donnersm/CRTIMER/hardware/BOM_PCB_CR Timer_2022-02-24.csv

ID | Name | Designator | Footprint | Quantity | Manufacturer Part | Manufacturer | Supplier | Supplier Part | Price
1 | MM1Z5V1 | D1 | SOD-123_L2.7-W1.6-LS3.7-RD | 1 | MM1Z5V1 | SEMTECH | LCSC | C81601 | 0.018
2 | 1K | R9,R3,R2,R6 | R0805 | 4 | 0805W8F1001T5E | UniOhm | LCSC | C17513 | 0.002
3 | Arduino_Nano_Header | J1 | DIP-30_L43.18-W15.24-ARDUINONANO | 1
4 | HL-PC-2012H322W-L | LED1 | LED0805-RD | 1 | HL-PC-2012H322W-L(6000K-7000K) | HONGLITRONIC(Hongli Zhihui (HONGLITRONIC)) | LCSC | C497944 | 0.017
5 | FDN340P | Q1 | SOT-23-3_L2.9-W1.3-P1.90-LS2.4-BR | 1 | FDN340P | TECH PUBLIC(台舟) | LCSC | C2890122 | 0.057
6 | 74HC4050D,653 | U2 | SOP-16_L10.0-W3.9-P1.27-LS6.0-BL | 1 | 74HC4050D,653 | Nexperia | LCSC | C43181 | 0.33
7 | 10uF | C1,C2 | C1206 | 2 | CL31A106KBHNNNE | SAMSUNG | LCSC | C13585 | 0.041
8 | 100nF | C3,C4,C5,C7 | C0805 | 4 | CC0805KRX7R9BB104 | YAGEO | LCSC | C49678 | 0.005
9 | DS1139-06-08SS4BSR | CARD1 | TF-SMD_DS1139-06-08SS4BSR | 1 | DS1139-06-08SS4BSR | CONNFLY | LCSC | C86574 | 0.268
10 | 22041021 | CN2,CN3,CN4 | CONN-TH_22041021 | 3 | 22041021 | MOLEX | LCSC | C185215 | 0.09
11 | 22041031 | P1 | CONN-TH_3P-P2.54_22041031 | 1 | 22041031 | MOLEX | LCSC | C293437 | 0.089
12 | FDN335N | Q2,Q3 | SOT-23-3_L2.9-W1.3-P1.90-LS2.4-BR | 2 | FDN335N | HUASHUO | LCSC | C845588 | 0.038
13 | 10K | R1,R4,R5 | R0805 | 3 | 0805W8F1002T5E | UniOhm | LCSC | C17414 | 0.002
14 | 470 | R7 | R0805 | 1 | 0805W8F4700T5E | UniOhm | LCSC | C17710 | 0.003
15 | TS-1071AS-A1B3-D4 | SW1 | SW-SMD_L4.0-W3.0-LS4.8 | 1 | TS-1071AS-A1B3-D4 | Yuandi | LCSC | C492861 | 0.113
16 | AMS1117-5.0_C347223 | U1 | SOT-223_L6.7-W3.5-P2.30-BR | 1 | AMS1117-5.0 | Youtai Semiconductor Co., Ltd. | LCSC | C347223 | 0.081
17 | LP2985-50DBVR | U3 | SOT-23-5_L3.0-W1.7-P0.95-LS2.8-BR | 1 | LP2985-50DBVR | Texas Instruments | LCSC | C74511 | 0.403
18 | PINHEADER1X7 | U4 | PINHEADER1X8N | 0 |  |  |  | undefined
19 | PINHEADER1X8 | U5 | PINHEADER1X8 | 0 |  |  |  | undefined
20 | BC547CTA | Q4 | TO-92-3_L4.8-W3.7-P2.54-L | 1 | BC547CTA | onsemi(安森美) | LCSC | C900799 | 0.085
21 | 4.7K | R8 | R0805 | 1 | 0805W8F4701T5E | UniOhm | LCSC | C17673 | 0.003
