donnersm/CRTIMER/hardware/Schematic_CR Timer_2022-01-15.pdf

# 4Y 10 5A 11 5Y 12 N.C 13 6A 14 6Y 15 N.C 16

## SD CARD

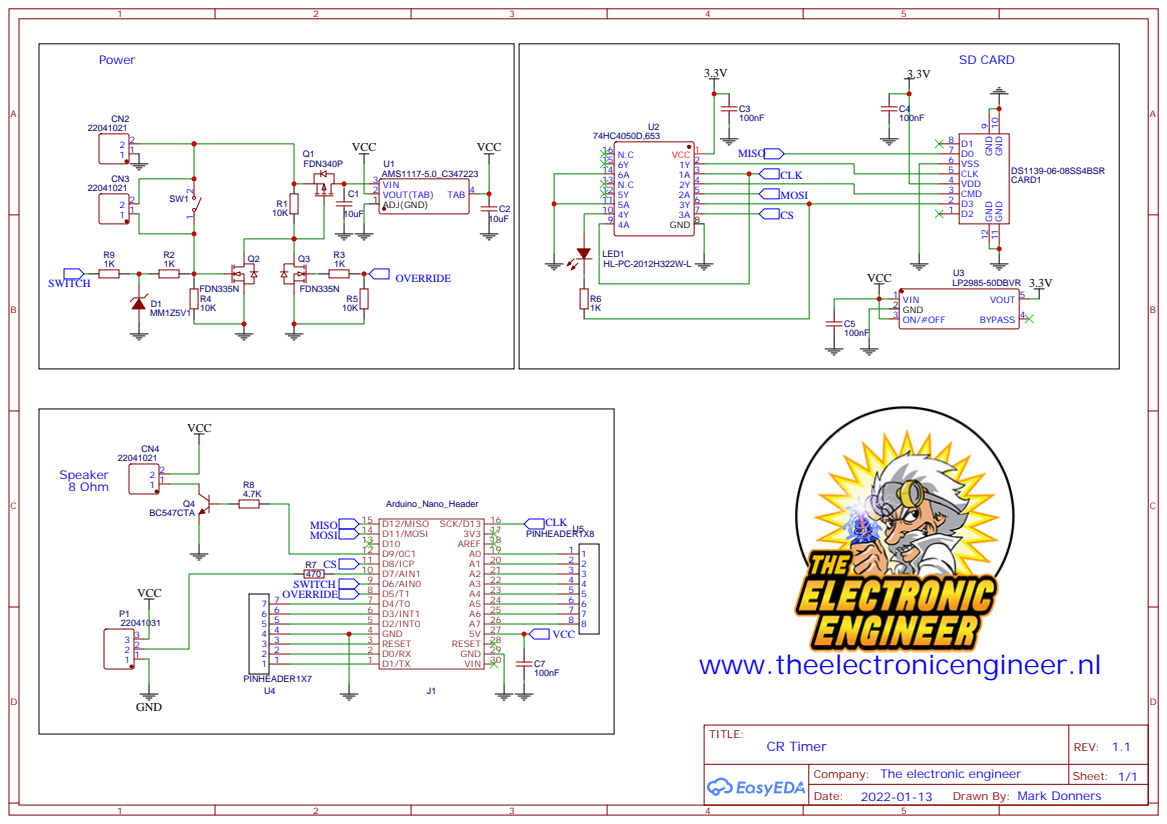
[picture p1: page 1]

Company: The electronic engineer

Drawn By: Mark Donners
