donnersm/CRTIMER/hardware/assembly.pdf

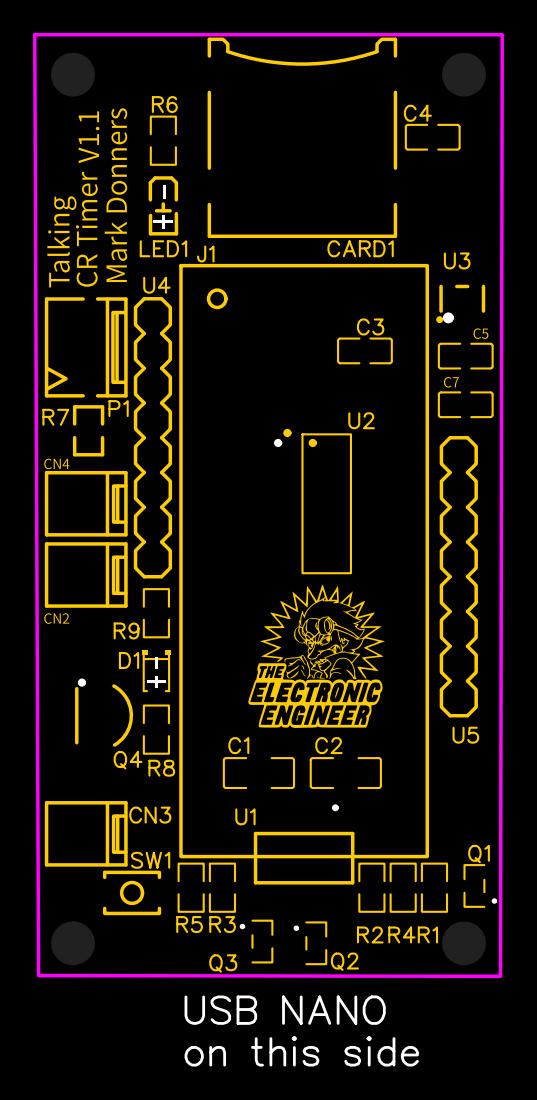
[picture p2: page 1]
